UCLAdmaFABLAB/encoder-and-stepper-demo/Photos/Encoder_back_parts.jpg

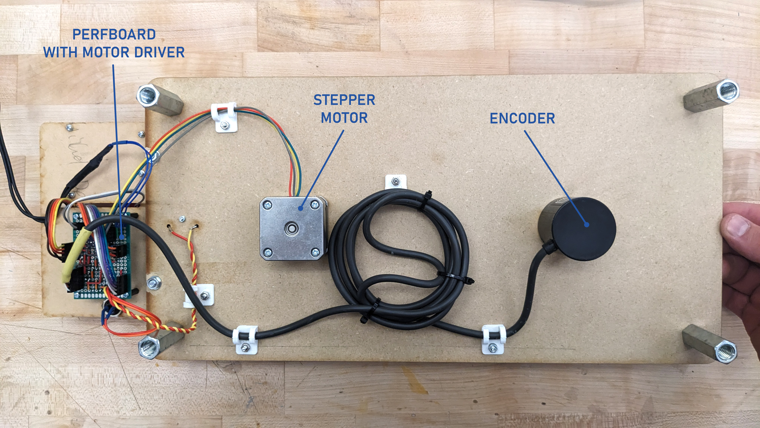
Photos/Encoder_back_parts.jpg
