UCLAdmaFABLAB/encoder-and-stepper-demo/Photos/Encoder_detail_02.jpg

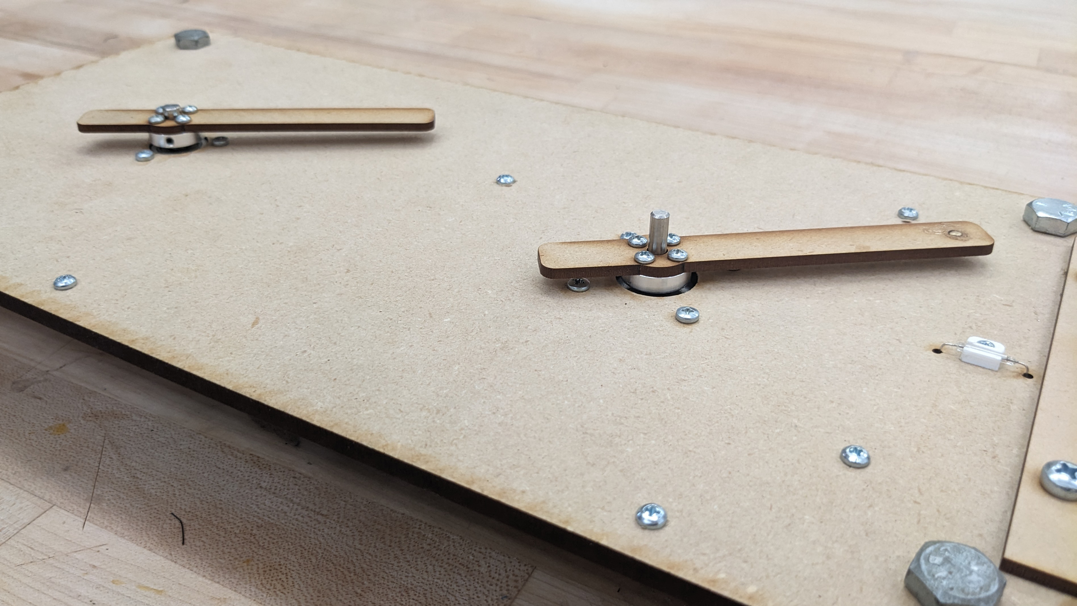
Photos/Encoder_detail_02.jpg
