UCLAdmaFABLAB/encoder-and-stepper-demo/Photos/Encoder_back.jpg

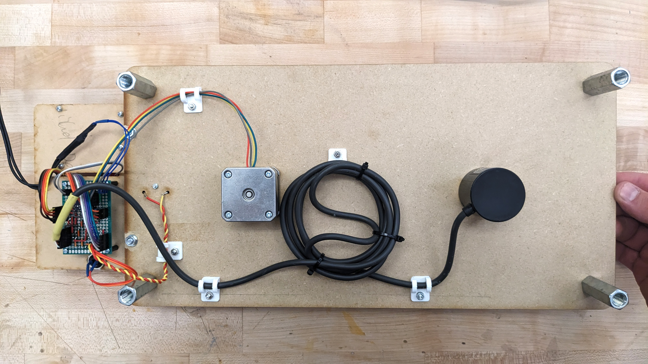
Photos/Encoder_back.jpg
