UCLAdmaFABLAB/encoder-and-stepper-demo/Photos/Encoder_detail_01.jpg

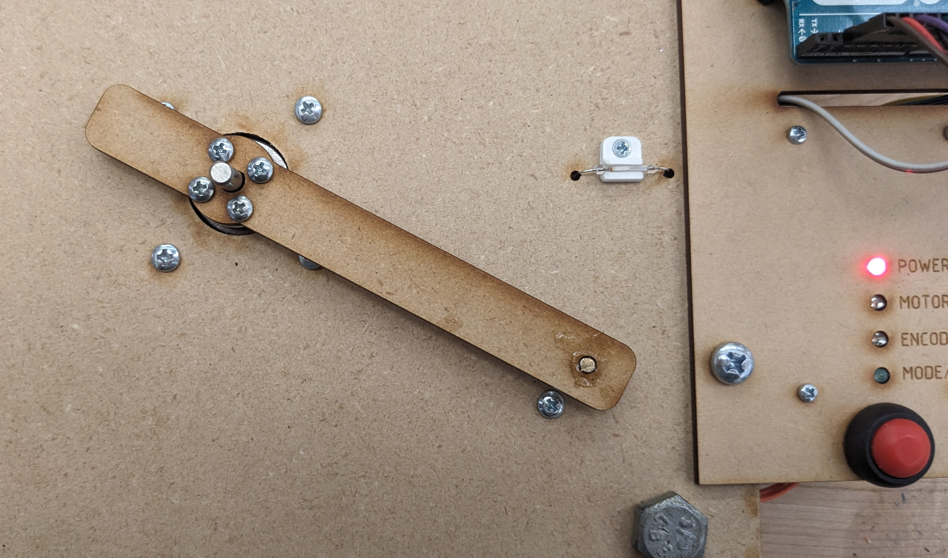
Photos/Encoder_detail_01.jpg
