UCLAdmaFABLAB/encoder-and-stepper-demo/Fabrication/CableGuide v3.stl

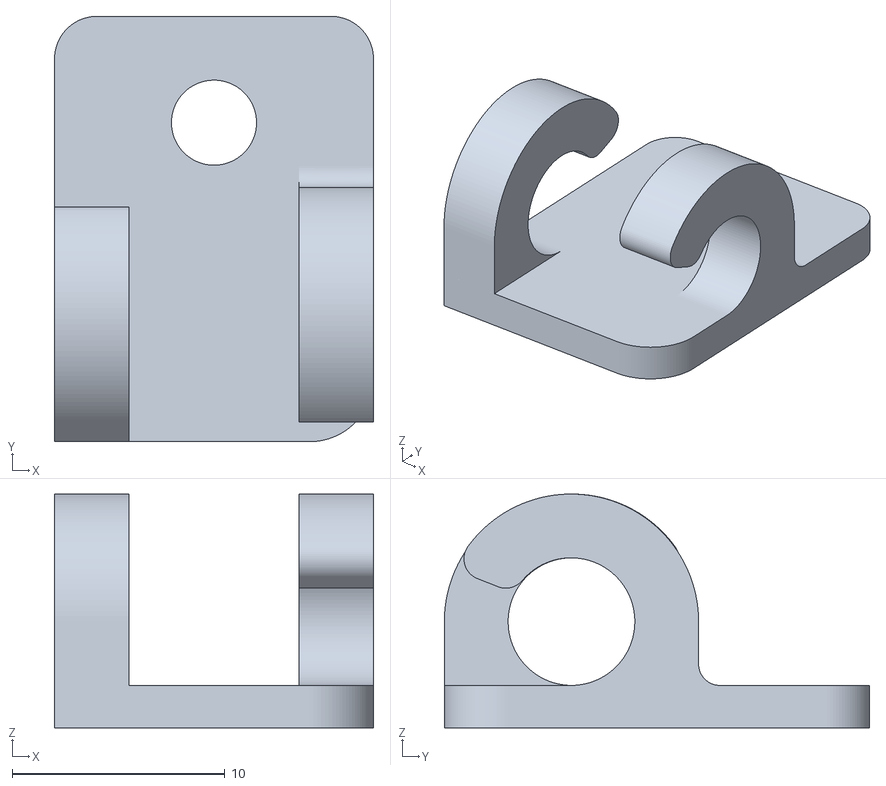
[picture p5: CAD file, 2023-12-14]
Fabrication/CableGuide v3.stl
15.0 x 20.0 x 11.0
