UCLAdmaFABLAB/encoder-and-stepper-demo/Fabrication/Reed Switch Holder v2.stl

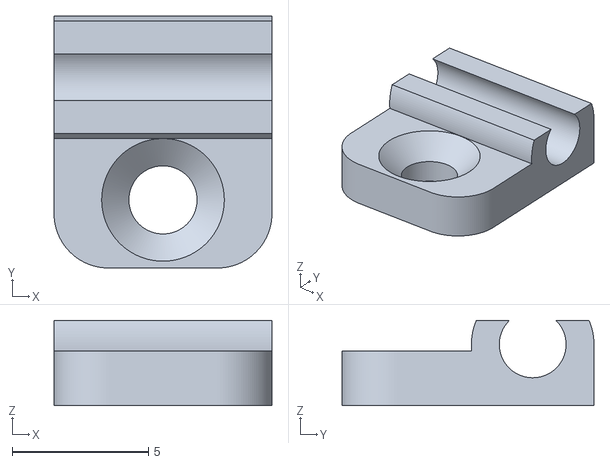
[picture p6: CAD file, 2023-12-14]
Fabrication/Reed Switch Holder v2.stl
8.00 x 9.25 x 3.14
