UCLAdmaFABLAB/encoder-and-stepper-demo/(list of files, cad)

Other CAD files:
Fabrication/CableGuide v3.f3d
Fabrication/Reed Switch Holder v2.f3d
