UCLAdmaFABLAB/encoder-and-stepper-demo/Schematic.pdf

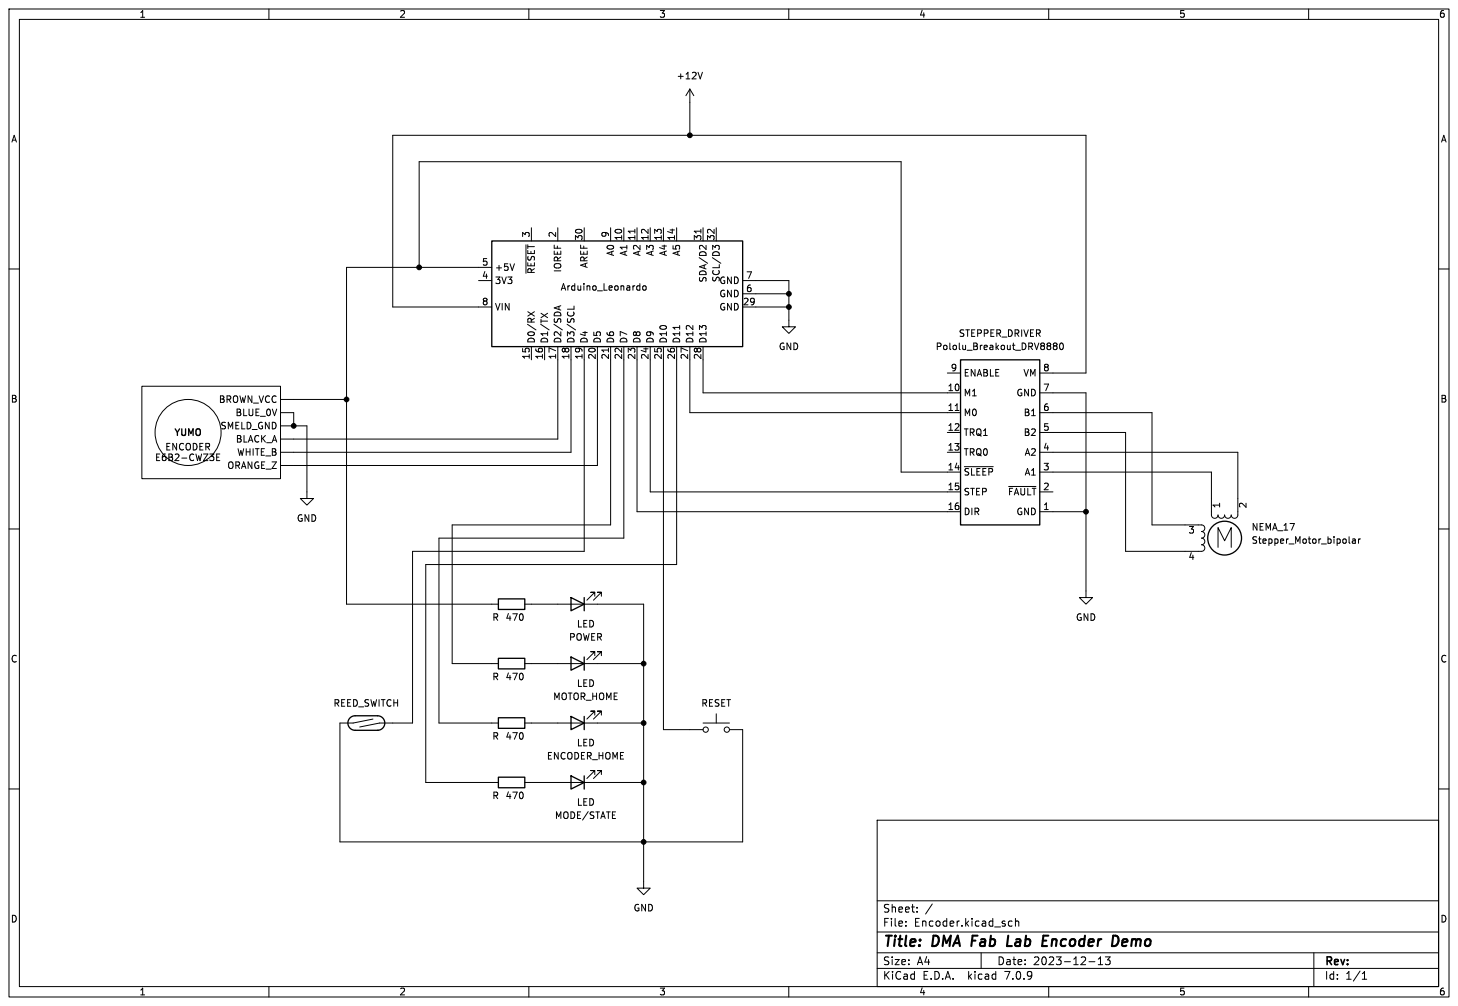
[picture p7: page 1]

2 D5 20 D6 21 D7 22 D8 23 D9 24 D10 25 D11 26 D12 27 D13 28 GND 29 ~{RESET}3 AREF 30 SDA/D2 31 SCL/D3 32

Id: 1/1 Title: DMA Fab Lab Encoder Demo
